MarcoStrassia/UltimateVroom/MotorController-Rebuild/docs/boosted-v1-esc-reference.png

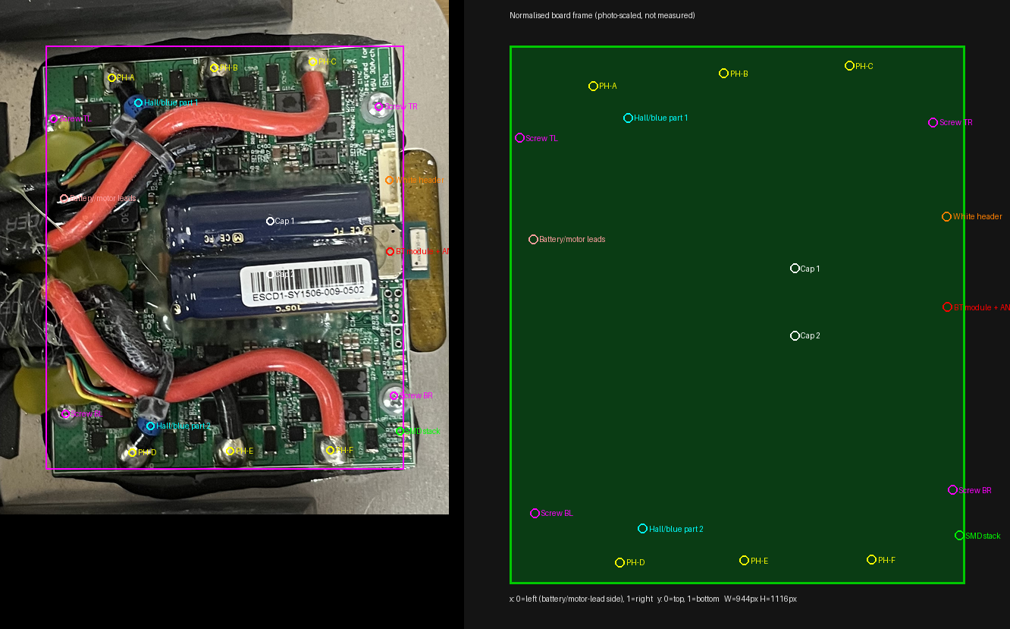
MotorController-Rebuild/docs/boosted-v1-esc-reference.png
