MarcoStrassia/UltimateVroom/MotorController-Rebuild/docs/photos/esc-corner-leds.jpg

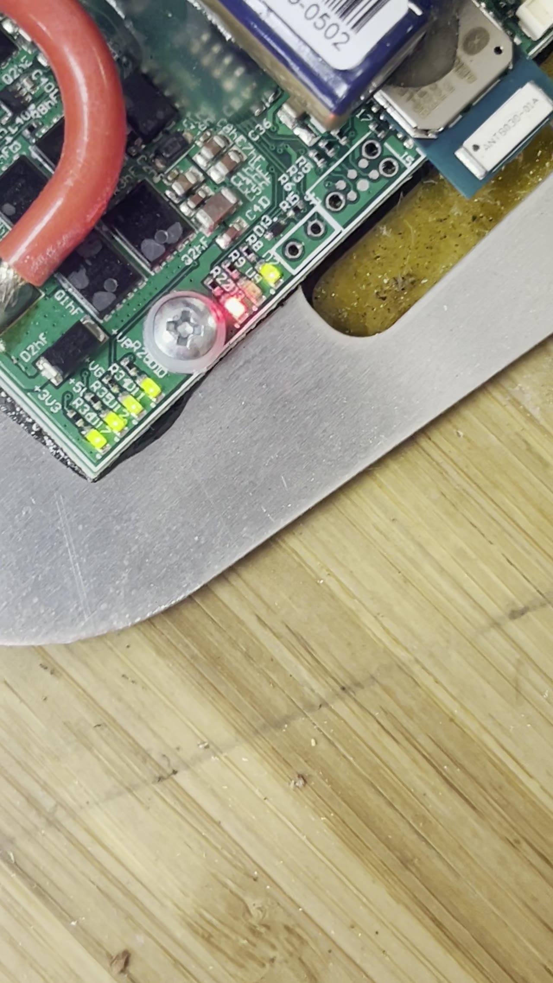
MotorController-Rebuild/docs/photos/esc-corner-leds.jpg
