MarcoStrassia/UltimateVroom/MotorController-Rebuild/docs/photos/esc-angled.jpg

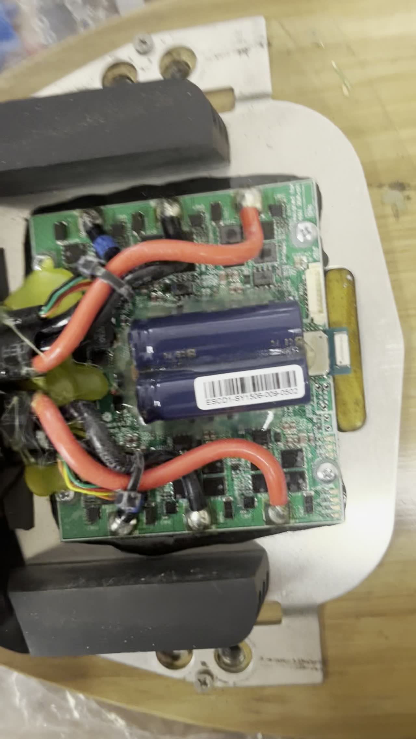
MotorController-Rebuild/docs/photos/esc-angled.jpg
