MarcoStrassia/UltimateVroom/MotorController-Rebuild/docs/photos/esc-top-crop.jpg

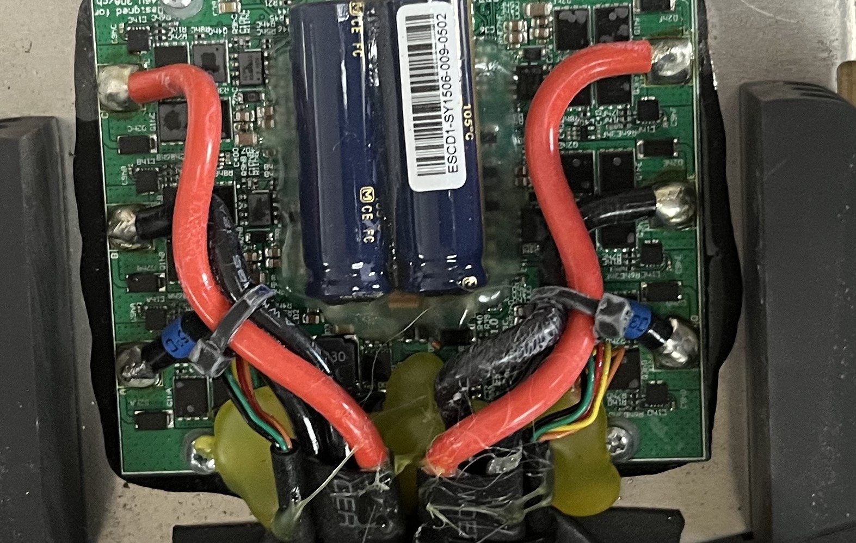
MotorController-Rebuild/docs/photos/esc-top-crop.jpg
