MarcoStrassia/UltimateVroom/MotorController-Rebuild/docs/photos/esc-top.jpg

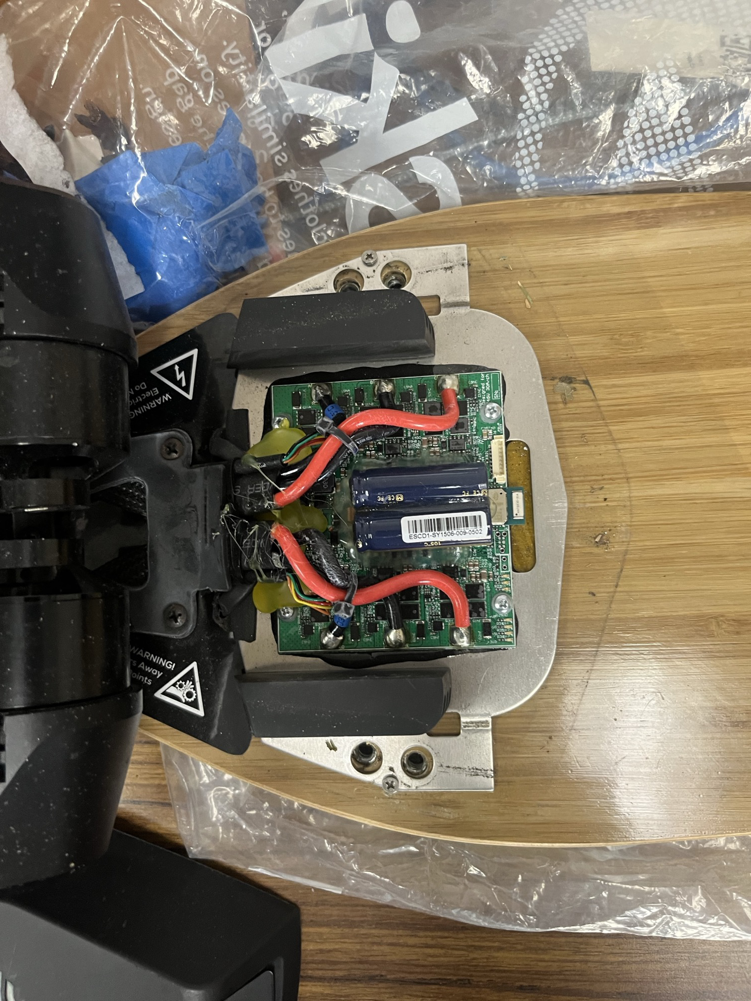
MotorController-Rebuild/docs/photos/esc-top.jpg
