MarcoStrassia/UltimateVroom/MotorController-Rebuild/review/current/previews/bottom.png

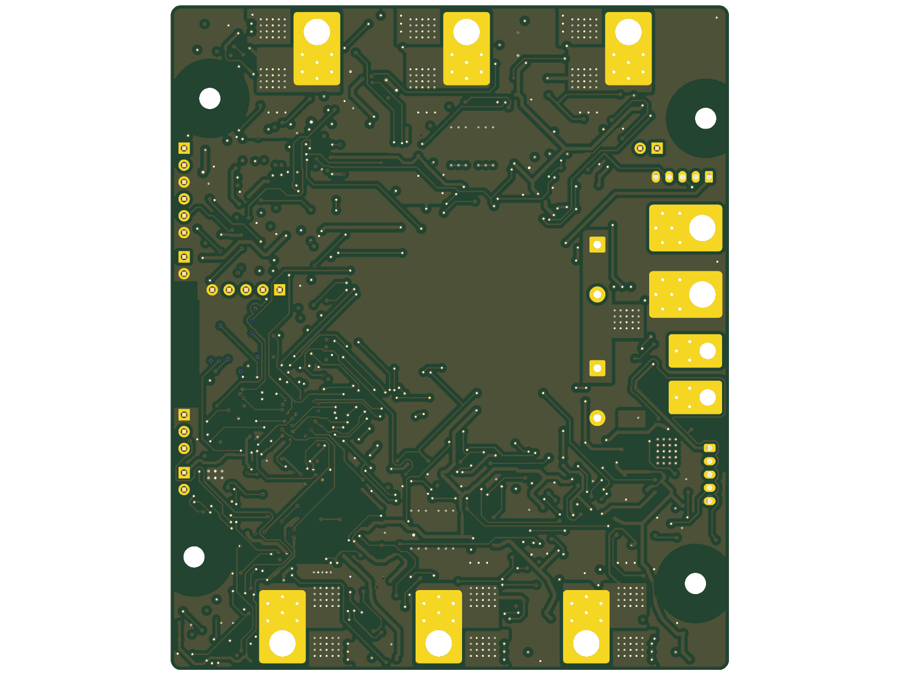
MotorController-Rebuild/review/current/previews/bottom.png
