MarcoStrassia/UltimateVroom/MotorController-Rebuild/review/current/previews/final-assembly.png

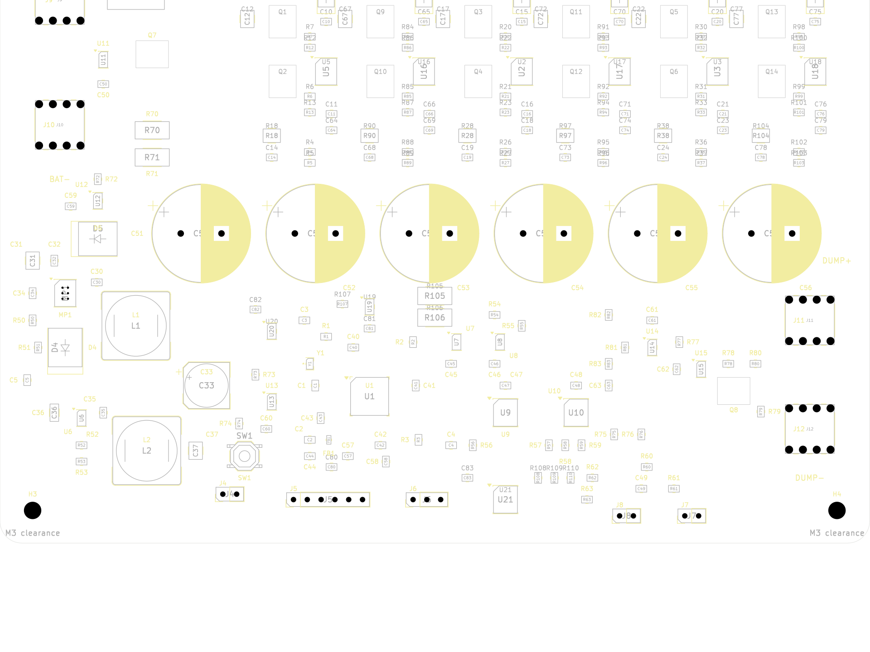
MotorController-Rebuild/review/current/previews/final-assembly.png
