MarcoStrassia/UltimateVroom/MotorController-Rebuild/review/current/previews/final-bottom.png

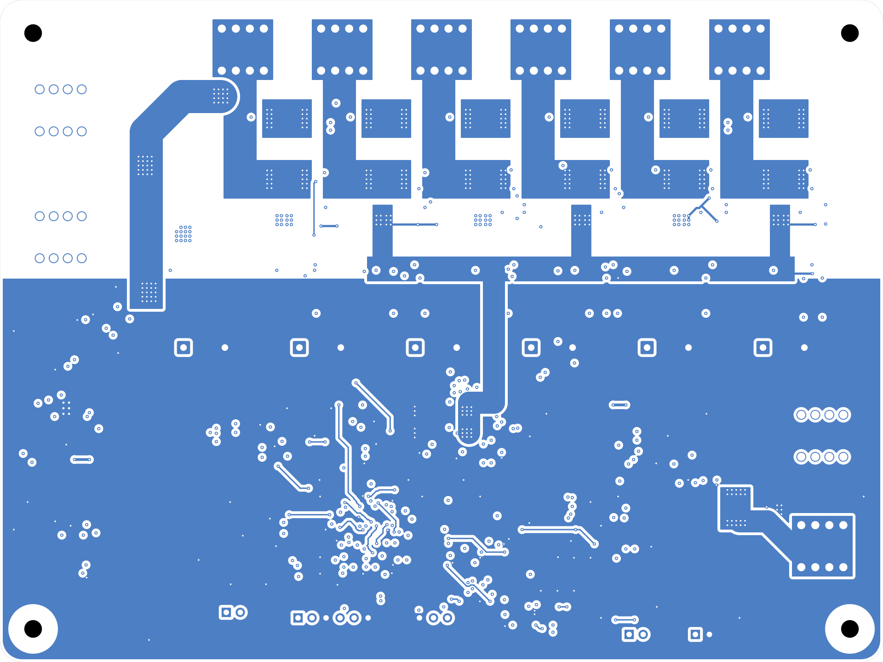
MotorController-Rebuild/review/current/previews/final-bottom.png
