MarcoStrassia/UltimateVroom/MotorController-Rebuild/review/current/previews/final-ground-in1.png

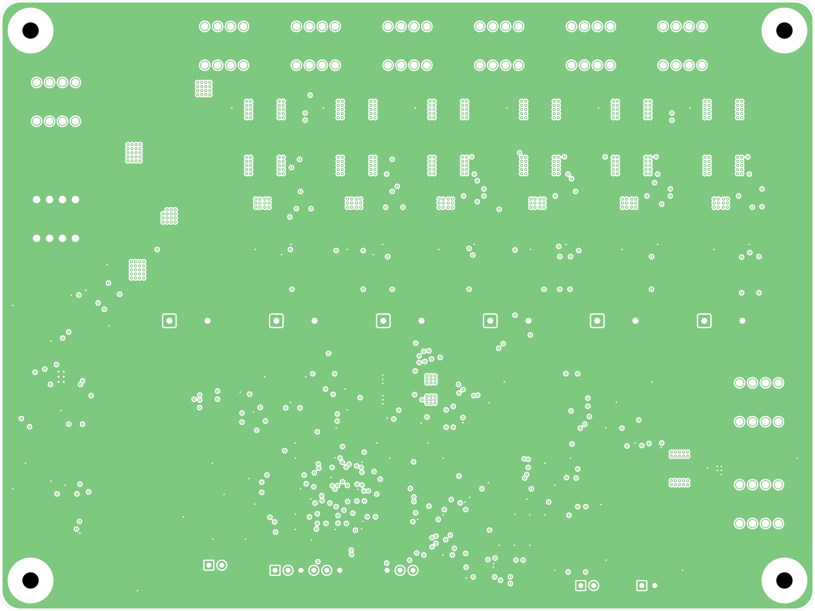
MotorController-Rebuild/review/current/previews/final-ground-in1.png
