MarcoStrassia/UltimateVroom/MotorController-Rebuild/review/current/previews/final-power-in2.png

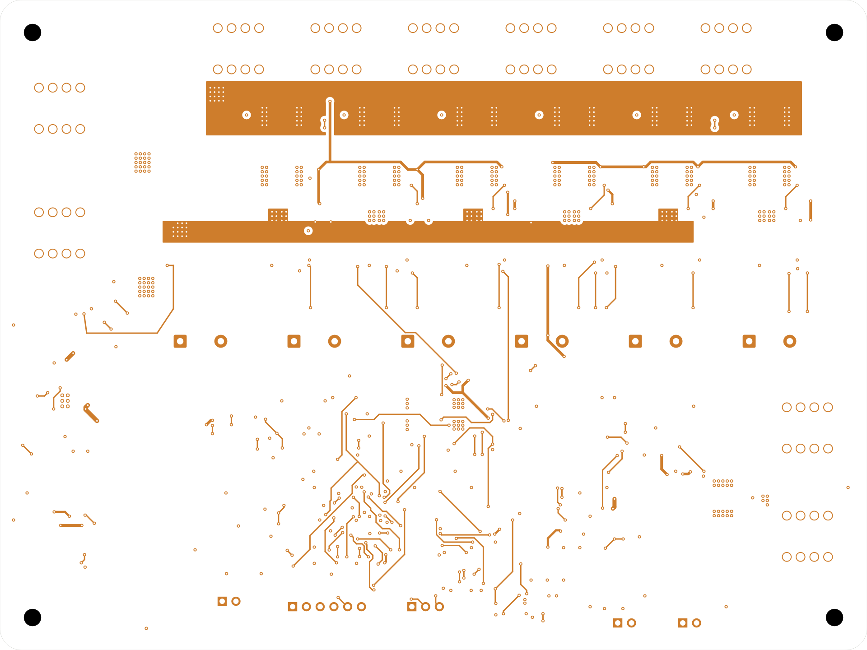
MotorController-Rebuild/review/current/previews/final-power-in2.png
