MarcoStrassia/UltimateVroom/MotorController-Rebuild/review/current/previews/final-top.png

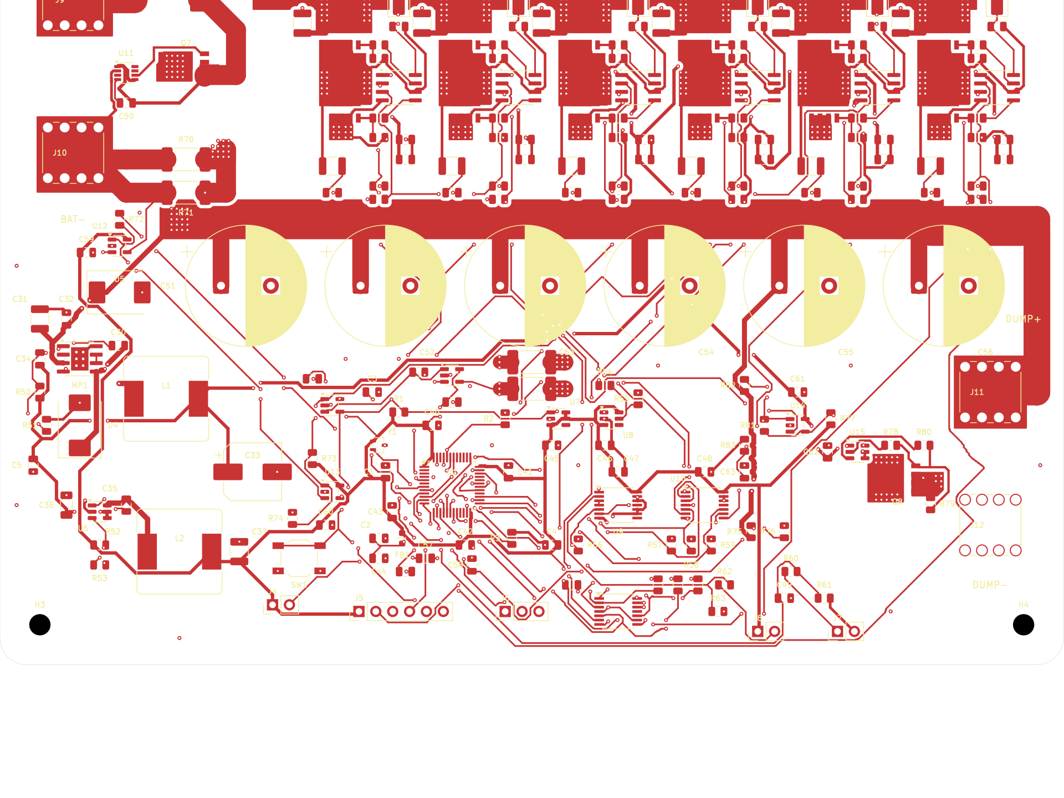
MotorController-Rebuild/review/current/previews/final-top.png
