MarcoStrassia/UltimateVroom/MotorController-Rebuild/review/current/previews/placement-top.png

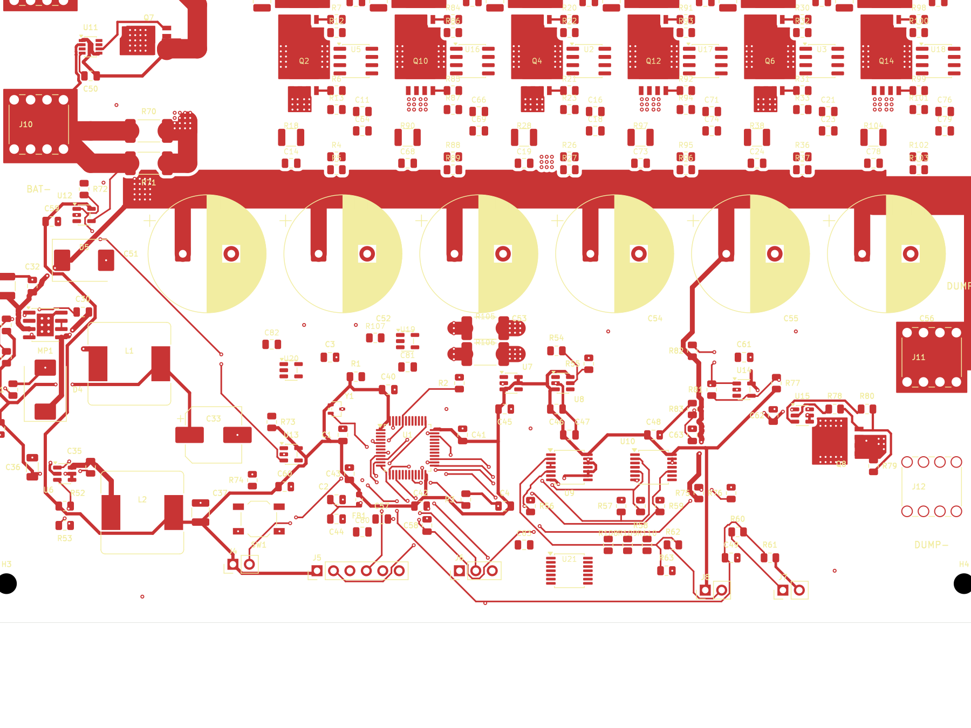
MotorController-Rebuild/review/current/previews/placement-top.png
