MarcoStrassia/UltimateVroom/MotorController-Rebuild/review/current/previews/top.png

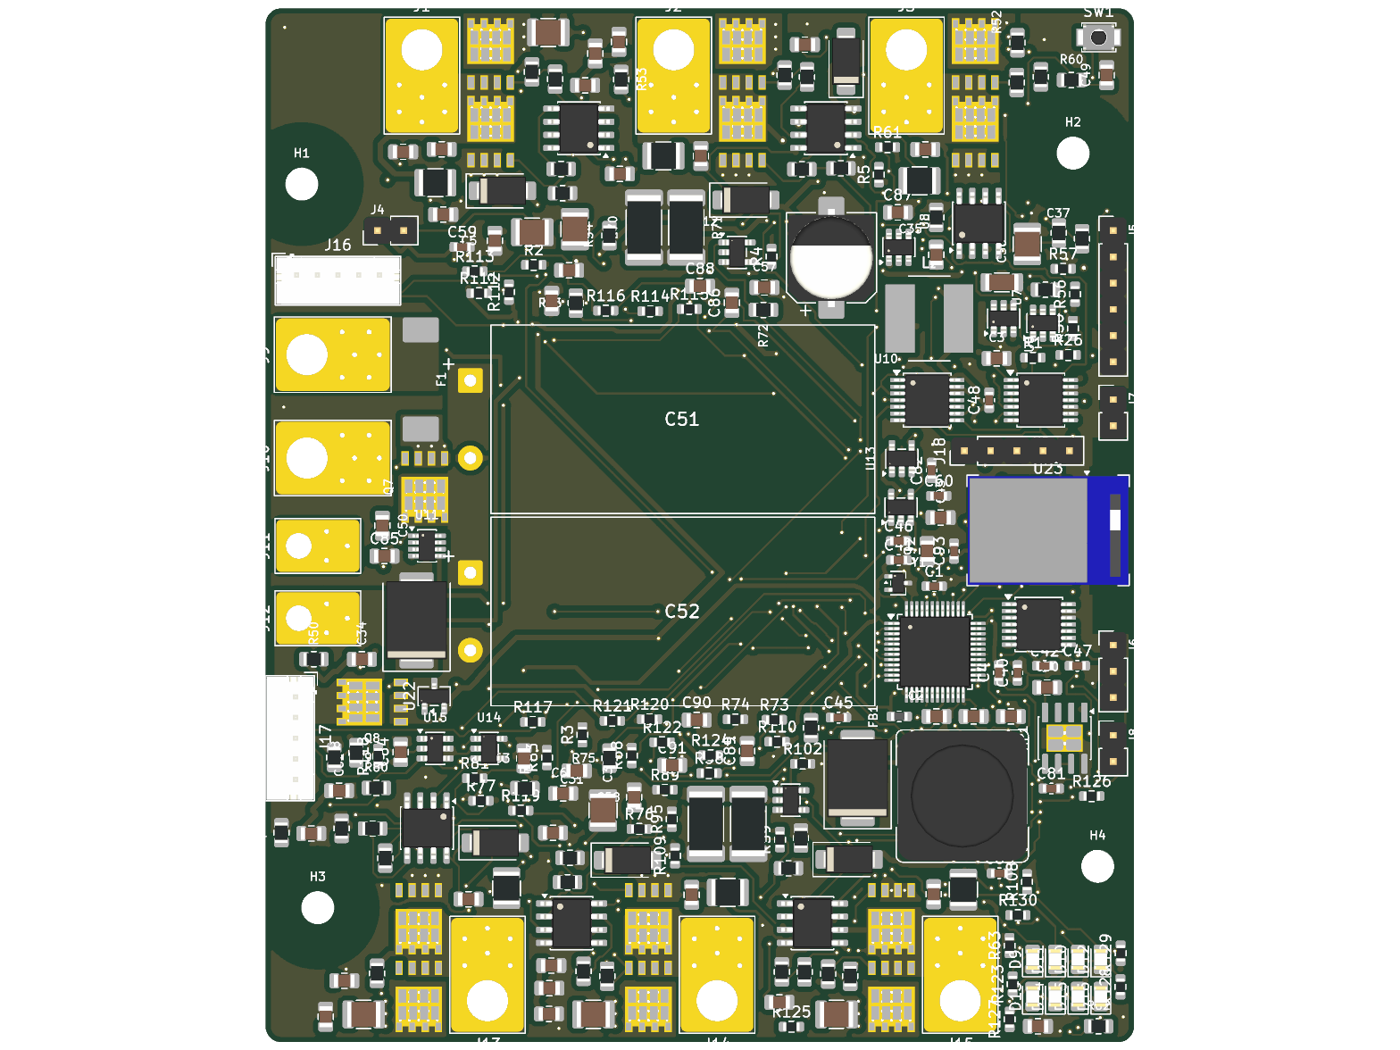
MotorController-Rebuild/review/current/previews/top.png
