MarcoStrassia/UltimateVroom/MotorController-Rebuild/review/current/previews/final-schematic.pdf

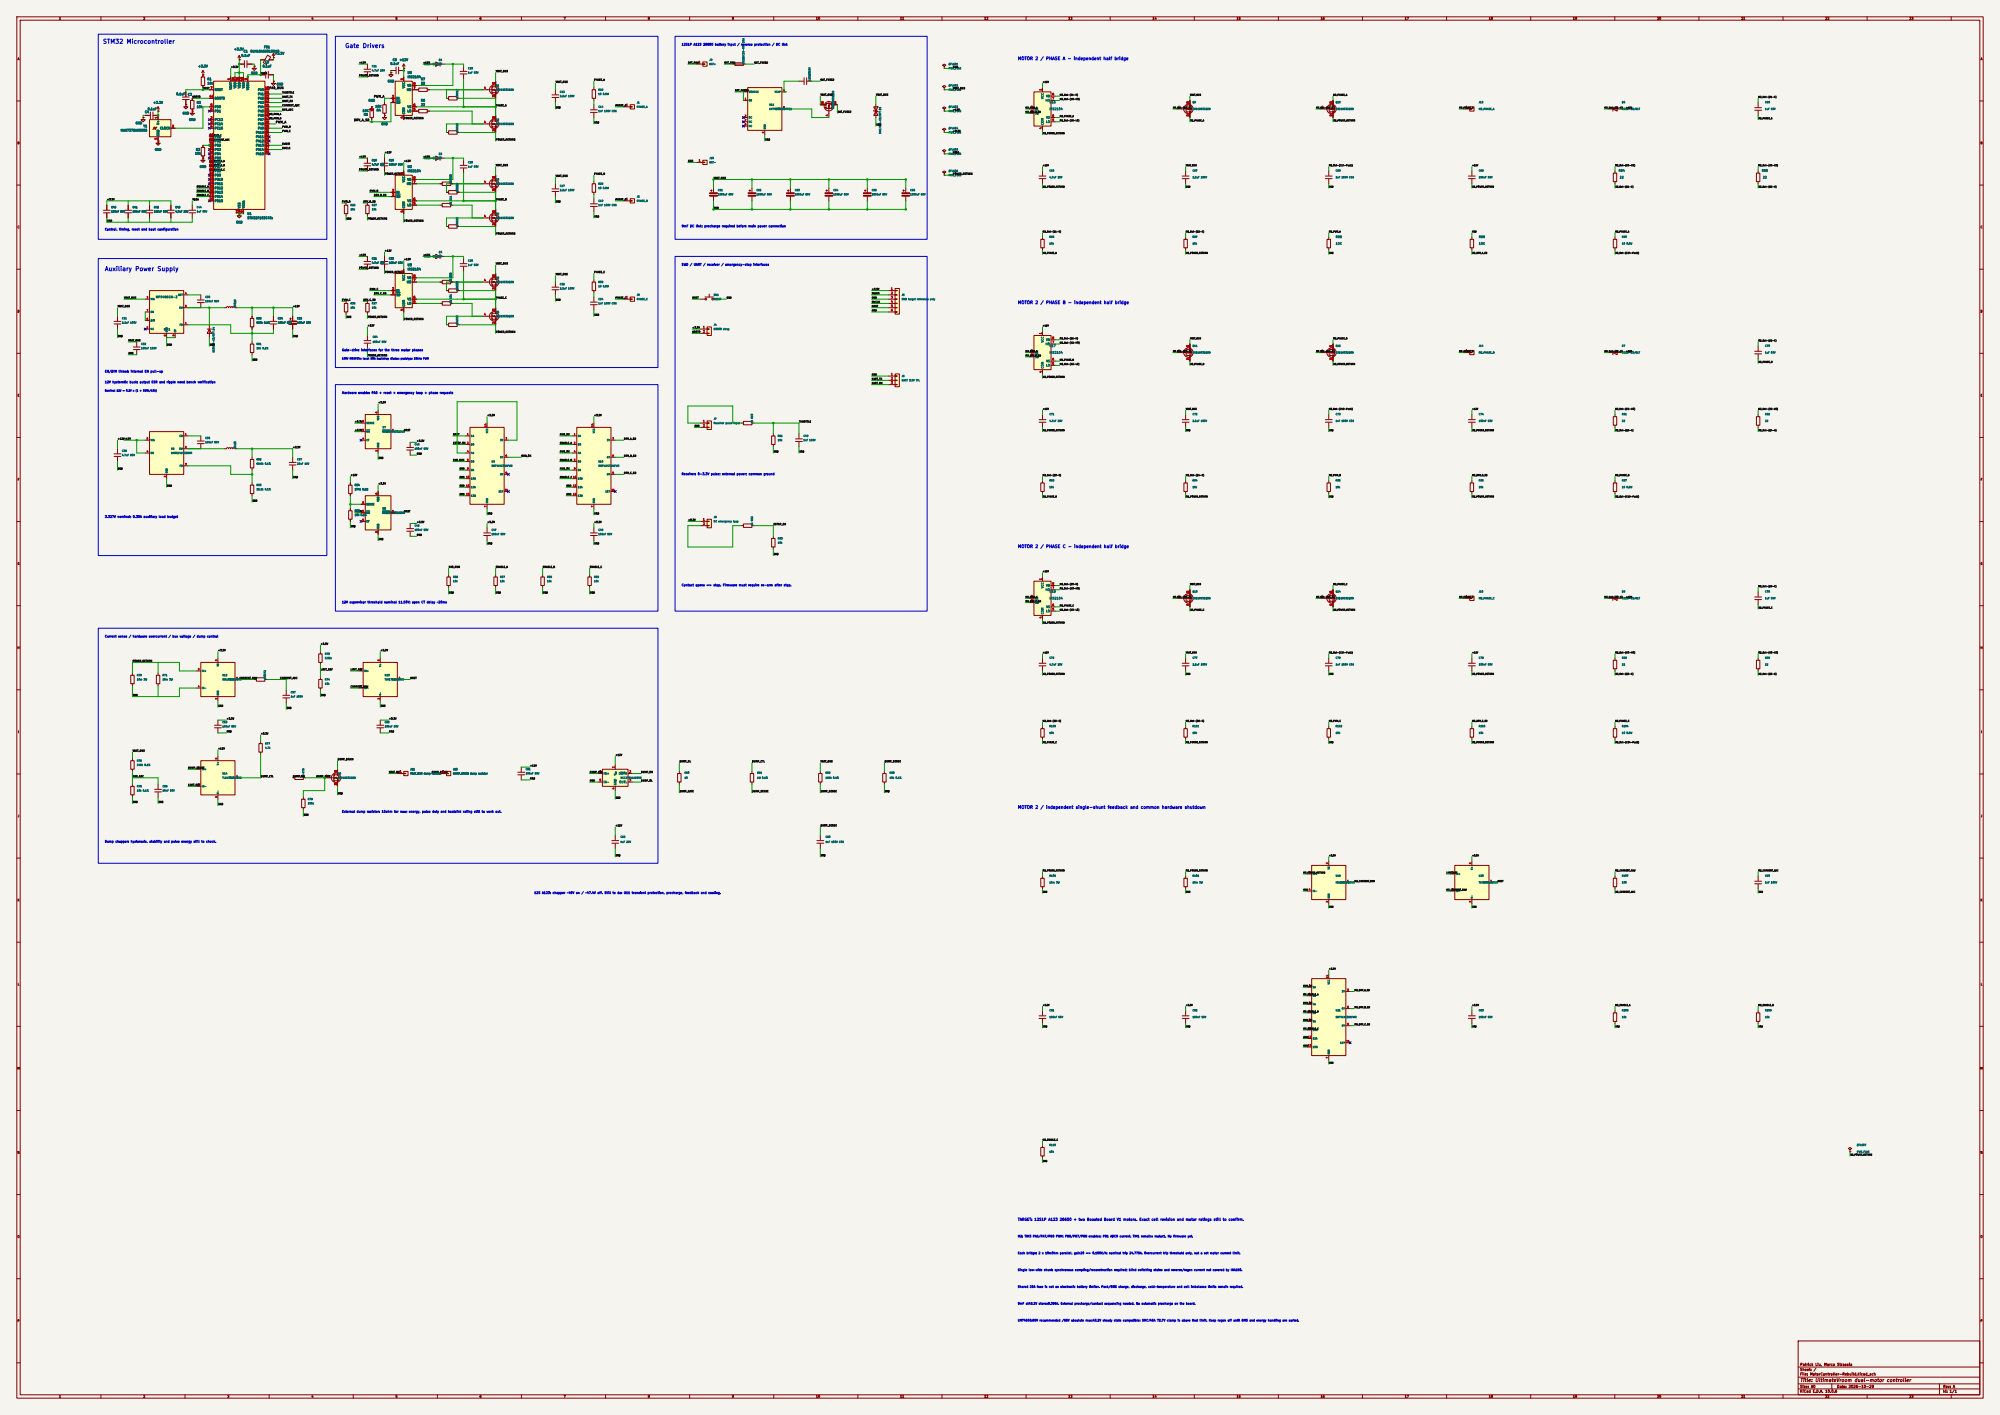
[picture p15: page 1]

12S1P A123 26650 battery input / reverse protection / DC link

MOTOR 2 / PHASE A - independent half bridge

SWD / UART / receiver / emergency-stop interfaces 9mF DC link; precharge required before main power connection Control, timing, reset and boot configuration

SWD target reference only

MOTOR 2 / PHASE B - independent half bridge
4.7uF 25V VCC

100V MOSFETs; local SMA bootstrap diodes; prototype 20kHz PWM

EN/DIM linked; internal EN pull-up

Hardware enable: PA0 + reset + emergency loop + phase requests

3.327V nominal; 0.30A auxiliary load budget

MOTOR 2 / PHASE C - independent half bridge

Contact opens => stop. Firmware must require re-arm after stop.

MOTOR 2 / independent single-shunt feedback and common hardware shutdown

Dump chopper: hysteresis, stability and pulse energy still to check.

12S A123: chopper ~48V on / ~47.4V off. Still to do: U11 transient protection, precharge, feedback and cooling.

TARGET: 12S1P A123 26650 + two Boosted Board V1 motors. Exact cell revision and motor ratings still to confirm.

M2: TIM3 PA6/PA7/PB0 PWM; PB6/PB7/PB8 enables; PB1 ADC9 current. TIM1 remains motor1. No firmware yet.

Each bridge: 2 x 10mOhm parallel, gain20 => 0.100V/A; nominal trip 24.775A. Overcurrent trip threshold only, not a set motor current limit.

Single low-side shunt: synchronous sampling/reconstruction required; blind switching states and reverse/regen current not covered by INA180. Shared 20A fuse is not an electronic battery limiter. Pack/BMS charge, discharge, cold-temperature and cell imbalance limits remain required.

9mF at43.2V stores8.398J. External precharge/contact sequencing needed. No automatic precharge on the board.

LM74500:60V recommended /65V absolute max;43.2V steady state compatible; SMCJ45A 72.7V clamp is above that limit. Keep regen off until BMS and energy handling are sorted.

Patrick Liu, Marco Strassia
Sheet: /
File: MotorController-Rebuild.kicad_sch
Title: UltimateVroom dual-motor controller

Size: A0 | Rev: A
KiCad E.D.A. 10.0.6 | Id: 1/1
