MarcoStrassia/UltimateVroom/MotorController-Rebuild/MotorController-Rebuild.kicad_pcb

## KiCad design MotorController-Rebuild/MotorController-Rebuild.kicad_pcb (2026-11-01)

Schematic: MotorController-Rebuild.kicad_sch, UltimateVroom dual-motor controller

Parts:
C1, C4: 0.1uF; C_0603_1608Metric; MPN C0603C104K5RACTU
C2, C3, C5: 0.1uF; C_0805_2012Metric; MPN C0805C104K5RACTU
C10, C15, C20, C44, C65, C70, C75, C84, C85: 1uF 50V; C_0805_2012Metric; MPN C0805C105K5RACTU
C11, C16, C21, C43, C66, C71, C76: 4.7uF 25V; C_0805_2012Metric; MPN C0805C475K3RACTU
C12, C17, C22, C31, C67, C72, C77: 2.2uF 100V; C_1210_3225Metric; MPN C1210C225K1RACTU
C14, C19, C24, C68, C73, C78: 1nF 100V C0G; C_0805_2012Metric; MPN C0805C102J1GACTU
C18, C23, C61, C64, C69, C74, C79: 100nF 50V; C_0805_2012Metric
C30, C34, C35: 100nF 50V; C_0805_2012Metric; MPN C0805C104K5RACTU
C32: 100nF 100V; C_0805_2012Metric; MPN C0805C104K1RACTU
C33: 100uF 25V; CP_Elec_8x10.5; MPN EEE-FK1E101P
C36: 4.7uF 50V; C_1206_3216Metric; MPN C1206C475K5RACTU
C37: 22uF 16V; C_1210_3225Metric; MPN C1210C226K4RACTU
C40, C41, C42, C45, C46, C47, C48, C59, C60, C81, C82, C83, C93: 100nF 50V; C_0603_1608Metric; MPN C0603C104K5RACTU
C49, C57, C80: 1nF 100V; C_0805_2012Metric
C50: 220nF 50V; C_0805_2012Metric; MPN C0805C224K5RACTU
C51, C52: 1500uF 80V; CP_Radial_D18.0mm_L35.5mm_P7.50mm_Horizontal; MPN EKYB800ELL152MMP1S
C58: 10nF 50V; C_0805_2012Metric
C62: 1uF 25V; C_0805_2012Metric
C63: 1nF 100V C0G; C_0805_2012Metric
C86, C87, C88, C89, C90, C91: 4.7nF 50V; C_0805_2012Metric; MPN C0805C472K5RACTU
C92: 10uF 10V; C_0805_2012Metric; MPN GRM21BR61A106KE19L
D1, D2, D3, D6, D7, D8: US1G-E3/61T; D_SMA; MPN US1G-E3/61T
D4: SS3H10-E3/57T; D_SMC; MPN SS3H10-E3/57T
D5: SMCJ45A-E3/57T; D_SMC; MPN SMCJ45A-E3/57T
D9: 3V3 green; LED_0805_2012Metric; MPN LTST-C171GKT
D10: 5V green; LED_0805_2012Metric; MPN LTST-C171GKT
D11: VG 12V green; LED_0805_2012Metric; MPN LTST-C171GKT
D12: RUN green; LED_0805_2012Metric; MPN LTST-C171GKT
D13: FAULT red; LED_0805_2012Metric; MPN LTST-C171KRKT
D14: BLE green; LED_0805_2012Metric; MPN LTST-C171GKT
D15: M1 ARM green; LED_0805_2012Metric; MPN LTST-C171GKT
D16: M2 ARM green; LED_0805_2012Metric; MPN LTST-C171GKT
F1: 1025HC20-RTR 20A; Fuse_1025HC; MPN 1025HC20-RTR
FB1: BLM18AG601SN1D; L_0603_1608Metric
J1: PHASE_A; SolderPad_10AWG_7x11mm_D4.0mm
J2: PHASE_B; SolderPad_10AWG_7x11mm_D4.0mm
J3: PHASE_C; SolderPad_10AWG_7x11mm_D4.0mm
J4: BOOT0 strap; PinHeader_1x02_P2.54mm_Vertical
J5: SWD target reference only; PinHeader_1x06_P2.54mm_Vertical
J6: UART 3.3V TTL; PinHeader_1x03_P2.54mm_Vertical
J7: Receiver pulse input; PinHeader_1x02_P2.54mm_Vertical
J8: NC emergency loop; PinHeader_1x02_P2.54mm_Vertical
J9: BAT+; SolderPad_10AWG_7x11mm_D4.0mm
J10: BAT-; SolderPad_10AWG_7x11mm_D4.0mm
J11: VBAT_BUS dump resistor; SolderPad_14AWG_5x8mm_D2.5mm
J12: DUMP_DRAIN dump resistor; SolderPad_14AWG_5x8mm_D2.5mm
J13: M2_PHASE_A; SolderPad_10AWG_7x11mm_D4.0mm
J14: M2_PHASE_B; SolderPad_10AWG_7x11mm_D4.0mm
J15: M2_PHASE_C; SolderPad_10AWG_7x11mm_D4.0mm
J16: HALL_M1 JST-PH 5p; JST_PH_B5B-PH-K_1x05_P2.00mm_Vertical; MPN B5B-PH-K-S(LF)(SN)
J17: HALL_M2 JST-PH 5p; JST_PH_B5B-PH-K_1x05_P2.00mm_Vertical; MPN B5B-PH-K-S(LF)(SN)
J18: BLE SWD; PinHeader_1x05_P2.54mm_Vertical; MPN PH1-05-UA (2.54 mm header)
L1: 100uH; L_Bourns_SRR1260; MPN SRR1260-101M
L2: 22uH; L_Bourns_SRN8040TA; MPN SRN8040TA-220M
MP1: MP9486GN-Z; MP9486_SOIC8_EP_0p4mm_thermal; Manufactuer PN MP9486GN-Z
Q1, Q2, Q3, Q4, Q5, Q6, Q7, Q8, Q9, Q10, Q11, Q12, Q13, Q14: CSD19532Q5B
R1, R2, R3: 10k; R_0603_1608Metric; Manufactuer PN CRT0603-BY-1002ELF
R4, R5, R88, R89: 10K; R_0603_1608Metric
R6, R7, R20, R21, R30, R31, R84, R85, R91, R92, R98, R99: 22; R_0805_2012Metric
R12, R13, R22, R23, R27, R32, R33, R37, R86, R87, R93, R94, R96, R100, R101, R103: 10k; R_0805_2012Metric
R18, R28, R38, R90, R97, R104: 10 0.5W; R_1210_3225Metric; MPN CRCW121010R0FKEA
R26, R36, R56, R57, R58, R59, R61, R63, R74, R95, R102, R108, R109, R110: 10k; R_0603_1608Metric
R50: 590k 0.1%; R_0805_2012Metric; MPN TNPW0805590KBEEA
R51, R55: 10k 0.1%; R_0805_2012Metric; MPN TNPW080510K0BEEA
R52: 69.8k 0.1%; R_0805_2012Metric; MPN TNPW080569K8BEEA
R53: 22.1k 0.1%; R_0805_2012Metric; MPN TNPW080522K1BEEA
R54: 274k 0.1%; R_0805_2012Metric; MPN TNPW0805274KBEEA
R60, R62: 1k; R_0805_2012Metric
R70, R71, R105, R106: 10m 3W; WSLP2512_10m; MPN WSLP2512R0100FEA
R72, R107: 100; R_0805_2012Metric
R73: 3.32k; R_0603_1608Metric
R75: 249k 0.1%; R_0805_2012Metric
R76, R83: 10k 0.1%; R_0603_1608Metric
R77: 4.7k; R_0603_1608Metric
R78, R80: 10; R_0805_2012Metric
R79: 100k; R_0805_2012Metric
R81: 1M 0.1%; R_0603_1608Metric
R82: 182k 0.1%; R_0805_2012Metric
R111, R112, R113, R117, R118, R119, R124: 2.2k; R_0603_1608Metric; MPN RC0603FR-072K2L
R114, R115, R116, R120, R121, R122: 10k; R_0603_1608Metric; MPN RC0603FR-0710KL
R123, R126, R127, R130: 1k; R_0603_1608Metric; MPN RC0603FR-071KL
R125: 4.7k; R_0603_1608Metric; MPN RC0603FR-074K7L
R128, R129: 1.5k; R_0603_1608Metric; MPN RC0603FR-071K5L
SW1: RESET; SW_SPST_B3U-1000P; MPN B3U-1000P
U1: STM32F103C4Tx; LQFP-48_7x7mm_P0.5mm; MPN STM32F103C4T6
U2, U3, U5, U16, U17, U18: IRS2104; SOIC-8_3.9x4.9mm_P1.27mm; MPN IRS2104STRPBF
U6: LMR51410XDBVR; SOT-23-6; MPN LMR51410XDBVR
U7: TPS3808G33DBVR; SOT-23-6; MPN TPS3808G33DBVR
U8: TPS3808G01DBVR; SOT-23-6; MPN TPS3808G01DBVR
U9, U10, U21: SN74LVC08APWR; TSSOP-14_4.4x5mm_P0.65mm; MPN SN74LVC08APWR
U11: LM74500QDDFRQ1; TI_DDF0008A; MPN LM74500QDDFRQ1
U12, U19: INA180A1IDBVR; SOT-23-5; MPN INA180A1IDBVR
U13, U14, U20: TLV1701AIDBVR; SOT-23-5; MPN TLV1701AIDBVR
U15: UCC27511ADBVR; SOT-23-6
U22: TLV76050DBZR; SOT-23-3; MPN TLV76050DBZR
U23: MDBT50Q-1MV2; Raytac_MDBT50Q; MPN MDBT50Q-1MV2
Y1: MAX7375AXR805; SOT-323_SC-70; Manufactuer PN MAX7375AXR805+T

Connections:
+3.3V: C1.1, C4.2, C37.1, C40.1, C41.1, C42.1, C43.1, C45.1, C46.1, C47.1, C48.1, C59.1, C60.1, C81.1, C82.1, C83.1, C92.1, C93.1, FB1.2, J4.1, J5.1, J8.1, J18.1, L2.2, R1.1, R52.1, R73.1, R77.1, R111.1, R112.1, R113.1, R117.1, R118.1, R119.1, R123.1, R127.1, R128.1, R129.1, U1.1 (VBAT), U1.24 (VDD), U1.36 (VDD), U1.48 (VDD), U7.3 (~MR), U7.5 (SENSE), U7.6 (VDD), U8.3 (~MR), U8.6 (VDD), U9.14 (VCC), U10.14 (VCC), U12.5 (VS), U13.5 (V+), U19.5 (VS), U20.5 (V+), U21.14 (VCC), U23.28 (VDD), U23.30 (VDDH), Y1.1 (V+)
+5V: C85.1, J16.1, J17.1, R124.1, U22.1 (OUT)
+12V: C5.2, C11.1, C16.1, C18.1, C21.1, C23.1, C33.1, C34.1, C36.1, C61.1, C62.1, C64.1, C66.1, C69.1, C71.1, C74.1, C76.1, C79.1, C84.1, D1.2 (A), D2.2 (A), D3.2 (A), D6.2 (A), D7.2 (A), D8.2 (A), L1.2, R50.1, R54.1, R125.1, U2.1 (VCC), U3.1 (VCC), U5.1 (VCC), U6.4 (EN), U6.5 (VIN), U14.5 (V+), U15.1 (V_{DD}), U16.1 (VCC), U17.1 (VCC), U18.1 (VCC), U22.2 (IN)
/BAT_FUSED: C50.2, F1.2, Q7.1 (S), Q7.2 (S), Q7.3 (S), U11.1 (EN), U11.5 (SOURCE)
/BAT_RAW: F1.1, J9.1
/BLE_NRST: J18.4, U1.41 (PB5), U23.40 (P0.18)
/BLE_STATUS: D14.1 (K), U1.3 (PC14), U23.36 (P0.14)
/BLE_UART_RX: U1.43 (PB7), U23.22 (P0.06)
/BLE_UART_TX: U1.42 (PB6), U23.24 (P0.08)
/BOOT0: J4.2, R2.1, U1.44 (BOOT0)
/BUS_ADC: C58.1, R75.2, R76.1, U1.15 (PA5)
/CURRENT_ADC: C57.1, R72.2, U1.14 (PA4)
/CURRENT_RAW: R72.1, U12.1 (OUT), U13.3 (IN-)
/DRV_A_SD: R5.2, U5.3 (~SD), U10.3 (3Y)
/DRV_B_SD: R27.1, U2.3 (~SD), U10.6 (6Y)
/DRV_C_SD: R37.1, U3.3 (~SD), U10.8 (8Y)
/DUMP_CTL: R77.2, R81.1, U14.4 (OUT), U15.6 (IN+)
/DUMP_DRAIN: J12.1, Q8.5 (D), Q8.6 (D), Q8.7 (D), Q8.8 (D)
/DUMP_GATE: Q8.4 (G), R78.2, R79.1, R80.2
/DUMP_OH: R78.1, U15.2 (OUTH)
/DUMP_OL: R80.1, U15.3 (OUTL)
/DUMP_SENSE: C63.1, R81.2, R82.2, R83.1, U14.1 (IN+)
/ENABLE_A: R57.1, U1.25 (PB12), U10.2 (2B)
/ENABLE_B: R58.1, U1.26 (PB13), U10.5 (5B)
/ENABLE_C: R59.1, U1.27 (PB14), U10.10 (10B)
/ESTOP_OK: R62.2, R63.1, U9.2 (2B)
/LED_D9_A: D9.2 (A), R123.2
/LED_D10_A: D10.2 (A), R124.2
/LED_D11_A: D11.2 (A), R125.2
/LED_D12_A: D12.2 (A), R126.2
/LED_D13_A: D13.2 (A), R127.2
/LED_FAULT: D13.1 (K), U1.2 (PC13)
/LED_M1_ARMED: D15.1 (K), U1.4 (PC15)
/LED_M2_ARMED: R3.1, R130.1, U1.20 (PB2)
/LED_RUN: R126.1, U1.28 (PB15)
/LIMIT_REF: R73.2, R74.1, U13.1 (IN+), U14.3 (IN-), U20.1 (IN+)
/M1_HALL_A: J16.2, R111.2, R114.1
/M1_HALL_A_MCU: C86.1, R114.2, U1.38 (PA15)
/M1_HALL_B: J16.3, R112.2, R115.1
/M1_HALL_B_MCU: C87.1, R115.2, U1.39 (PB3)
/M1_HALL_C: J16.4, R113.2, R116.1
/M1_HALL_C_MCU: C88.1, R116.2, U1.21 (PB10)
/M2_CURRENT_ADC: C80.1, R107.2, U1.19 (PB1)
/M2_CURRENT_RAW: R107.1, U19.1 (OUT), U20.3 (IN-)
/M2_DRV_A_SD: R89.2, U16.3 (~SD), U21.3 (3Y)
/M2_DRV_B_SD: R96.1, U17.3 (~SD), U21.6 (6Y)
/M2_DRV_C_SD: R103.1, U18.3 (~SD), U21.8 (8Y)
/M2_ENABLE_A: R108.1, U1.32 (PA11), U21.2 (2B)
/M2_ENABLE_B: R109.1, U1.33 (PA12), U21.5 (5B)
/M2_ENABLE_C: R110.1, U1.45 (PB8), U21.10 (10B)
/M2_HALL_A: J17.2, R117.2, R120.1
/M2_HALL_A_MCU: C89.1, R120.2, U1.40 (PB4)
/M2_HALL_B: J17.3, R118.2, R121.1
/M2_HALL_B_MCU: C90.1, R121.2, U1.46 (PB9)
/M2_HALL_C: J17.4, R119.2, R122.1
/M2_HALL_C_MCU: C91.1, R122.2, U1.22 (PB11)
/M2_PHASE_A: C65.2, J13.1, Q9.1 (S), Q9.2 (S), Q9.3 (S), Q10.5 (D), Q10.6 (D), Q10.7 (D), Q10.8 (D), R86.2, R90.1, U16.6 (VS)
/M2_PHASE_B: C70.2, J14.1, Q11.1 (S), Q11.2 (S), Q11.3 (S), Q12.5 (D), Q12.6 (D), Q12.7 (D), Q12.8 (D), R93.2, R97.1, U17.6 (VS)
/M2_PHASE_C: C75.2, J15.1, Q13.1 (S), Q13.2 (S), Q13.3 (S), Q14.5 (D), Q14.6 (D), Q14.7 (D), Q14.8 (D), R100.2, R104.1, U18.6 (VS)
/M2_POWER_RETURN: C66.2, C69.2, C71.2, C74.2, C76.2, C79.2, Q10.1 (S), Q10.2 (S), Q10.3 (S), Q12.1 (S), Q12.2 (S), Q12.3 (S), Q14.1 (S), Q14.2 (S), Q14.3 (S), R87.2, R94.2, R96.2, R101.2, R103.2, R105.1, R106.1, U16.4 (COM), U17.4 (COM), U18.4 (COM), U19.3 (IN+)
/M2_PWM_A: R88.1, U1.16 (PA6), U16.2 (IN)
/M2_PWM_B: R95.1, U1.17 (PA7), U17.2 (IN)
/M2_PWM_C: R102.1, U1.18 (PB0), U18.2 (IN)
/NRST: C3.1, J5.5, R1.2, SW1.1, U1.7 (NRST), U7.1 (~RESET), U8.1 (~RESET), U9.1 (1A), U13.4 (OUT), U20.4 (OUT)
/PA0_RUN: R56.1, U1.10 (PA0), U9.5 (5B)
/PHASE_A: C10.2, J1.1, Q1.1 (S), Q1.2 (S), Q1.3 (S), Q2.5 (D), Q2.6 (D), Q2.7 (D), Q2.8 (D), R12.2, R18.1, U5.6 (VS)
/PHASE_B: C15.2, J2.1, Q3.1 (S), Q3.2 (S), Q3.3 (S), Q4.5 (D), Q4.6 (D), Q4.7 (D), Q4.8 (D), R22.2, R28.1, U2.6 (VS)
/PHASE_C: C20.2, J3.1, Q5.1 (S), Q5.2 (S), Q5.3 (S), Q6.5 (D), Q6.6 (D), Q6.7 (D), Q6.8 (D), R32.2, R38.1, U3.6 (VS)
/POWER_RETURN: C11.2, C16.2, C18.2, C21.2, C23.2, C64.2, Q2.1 (S), Q2.2 (S), Q2.3 (S), Q4.1 (S), Q4.2 (S), Q4.3 (S), Q6.1 (S), Q6.2 (S), Q6.3 (S), R13.2, R23.2, R27.2, R33.2, R37.2, R70.1, R71.1, U2.4 (COM), U3.4 (COM), U5.4 (COM), U12.3 (IN+)
/PWM_A: R4.1, U1.29 (PA8), U5.2 (IN)
/PWM_B: R26.1, U1.30 (PA9), U2.2 (IN)
/PWM_C: R36.1, U1.31 (PA10), U3.2 (IN)
/RUN_OK: U9.6 (6Y), U10.1 (1A), U10.4 (4A), U10.9 (9A), U21.1 (1A), U21.4 (4A), U21.9 (9A)
/SWCLK: J5.4, U1.37 (PA14)
/SWDIO: J5.2, U1.34 (PA13)
/THROTTLE: C49.1, R60.2, R61.1, U1.11 (PA1)
/UART_RX: J6.3, U1.13 (PA3)
/UART_TX: J6.2, U1.12 (PA2)
/VBAT_BUS: C12.1, C17.1, C22.1, C31.1, C32.1, C51.1, C52.1, C67.1, C72.1, C77.1, D5.1 (A1), J11.1, MP1.3 (VIN), Q1.5 (D), Q1.6 (D), Q1.7 (D), Q1.8 (D), Q3.5 (D), Q3.6 (D), Q3.7 (D), Q3.8 (D), Q5.5 (D), Q5.6 (D), Q5.7 (D), Q5.8 (D), Q7.5 (D), Q7.6 (D), Q7.7 (D), Q7.8 (D), Q9.5 (D), Q9.6 (D), Q9.7 (D), Q9.8 (D), Q11.5 (D), Q11.6 (D), Q11.7 (D), Q11.8 (D), Q13.5 (D), Q13.6 (D), Q13.7 (D), Q13.8 (D), R75.1, R82.1
/VDDA: C2.1, C44.1, FB1.1, U1.9 (VDDA)
GND: C1.2, C2.2, C3.2, C4.1, C5.1, C12.2, C14.2, C17.2, C19.2, C22.2, C24.2, C31.2, C32.2, C33.2, C36.2, C37.2, C40.2, C41.2, C42.2, C43.2, C44.2, C45.2, C46.2, C47.2, C48.2, C49.2, C51.2, C52.2, C57.2, C58.2, C59.2, C60.2, C61.2, C62.2, C63.2, C67.2, C68.2, C72.2, C73.2, C77.2, C78.2, C80.2, C81.2, C82.2, C83.2, C84.2, C85.2, C86.2, C87.2, C88.2, C89.2, C90.2, C91.2, C92.2, C93.2, D4.2 (A), D5.2 (A2), D9.1 (K), D10.1 (K), D11.1 (K), D12.1 (K), D16.1 (K), J5.3, J5.6, J6.1, J7.2, J10.1, J16.5, J17.5, J18.5, MP1.8 (GND), MP1.9 (EP), Q8.1 (S), Q8.2 (S), Q8.3 (S), R2.2, R3.2, R4.2, R5.1, R26.2, R36.2, R51.2, R53.2, R55.2, R56.2, R57.2, R58.2, R59.2, R61.2, R63.2, R70.2, R71.2, R74.2, R76.2, R79.2, R83.2, R88.2, R89.1, R95.2, R102.2, R105.2, R106.2, R108.2, R109.2, R110.2, SW1.2, U1.8 (VSSA), U1.23 (VSS), U1.35 (VSS), U1.47 (VSS), U6.2 (GND), U7.2 (GND), U8.2 (GND), U9.7 (GND), U9.9 (9A), U9.10 (10B), U9.12 (12A), U9.13 (13B), U10.7 (GND), U10.12 (12A), U10.13 (13B), U11.2 (GND), U12.2 (GND), U12.4 (IN-), U13.2 (V-), U14.2 (V-), U15.4 (GND), U15.5 (IN-), U19.2 (GND), U19.4 (IN-), U20.2 (V-), U21.7 (GND), U21.12 (12A), U21.13 (13B), U22.3 (GND), U23.1 (GND), U23.2 (GND), U23.15 (GND), U23.33 (GND), U23.55 (GND), Y1.3 (GND)
unnamed: C14.1, R18.2
unnamed: C19.1, R28.2
unnamed: C24.1, R38.2
unnamed: C68.1, R90.2
unnamed: C73.1, R97.2
unnamed: C78.1, R104.2
unnamed: C10.1, D1.1 (K), U5.8 (VB)
unnamed: C15.1, D2.1 (K), U2.8 (VB)
unnamed: C20.1, D3.1 (K), U3.8 (VB)
unnamed: C30.2, D4.1 (K), L1.1, MP1.5 (SW)
unnamed: C65.1, D6.1 (K), U16.8 (VB)
unnamed: C70.1, D7.1 (K), U17.8 (VB)
unnamed: C75.1, D8.1 (K), U18.8 (VB)
unnamed: D14.2 (A), R128.2
unnamed: D15.2 (A), R129.2
unnamed: D16.2 (A), R130.2
unnamed: J7.1, R60.1
unnamed: J8.2, R62.1
unnamed: J18.2, U23.51 (SWDIO)
unnamed: J18.3, U23.53 (SWDCLK)
unnamed: C30.1, MP1.4 (BST)
unnamed: MP1.6 (DIM), MP1.7 (EN)
unnamed: C34.2, MP1.1 (FB), R50.2, R51.1
unnamed: Q1.4 (G), R7.2, R12.1
unnamed: Q2.4 (G), R6.2, R13.1
unnamed: Q3.4 (G), R20.2, R22.1
unnamed: Q4.4 (G), R21.2, R23.1
unnamed: Q5.4 (G), R30.2, R32.1
unnamed: Q6.4 (G), R31.2, R33.1
unnamed: Q7.4 (G), U11.6 (GATE)
unnamed: Q9.4 (G), R84.2, R86.1
unnamed: Q10.4 (G), R85.2, R87.1
unnamed: Q11.4 (G), R91.2, R93.1
unnamed: Q12.4 (G), R92.2, R94.1
unnamed: Q13.4 (G), R98.2, R100.1
unnamed: Q14.4 (G), R99.2, R101.1
unnamed: U1.5 (PD0), Y1.2 (CLOCK)
unnamed: R20.1, U2.7 (HO)
unnamed: R21.1, U2.5 (LO)
unnamed: R30.1, U3.7 (HO)
unnamed: R31.1, U3.5 (LO)
unnamed: R7.1, U5.7 (HO)
unnamed: R6.1, U5.5 (LO)
unnamed: C35.1, U6.1 (CB)
unnamed: R52.2, R53.1, U6.3 (FB)
unnamed: C35.2, L2.1, U6.6 (SW)
unnamed: R54.2, R55.1, U8.5 (SENSE)
unnamed: U9.3 (3Y), U9.4 (4A)
unnamed: C50.1, U11.4 (VCAP)
unnamed: R84.1, U16.7 (HO)
unnamed: R85.1, U16.5 (LO)
unnamed: R91.1, U17.7 (HO)
unnamed: R92.1, U17.5 (LO)
unnamed: R98.1, U18.7 (HO)
unnamed: R99.1, U18.5 (LO)

Notes on the sheet:
Control, timing, reset and boot configuration
100V MOSFETs; local SMA bootstrap diodes; prototype 20kHz PWM
12V hysteretic buck: output ESR and ripple need bench verification
Nominal 12V = 0.2V x (1 + 590k/10k)
EN/DIM linked; internal EN pull-up
3.327V nominal; 0.30A auxiliary load budget
12V supervisor threshold nominal 11.50V; open CT delay ~20ms
Receiver: 0-3.3V pulse; external power; common ground
Contact opens => stop. Firmware must require re-arm after stop.
2 x 1500 uF / 80 V lying-flat cans (3 mF); ripple rating is the limit, see BOOSTED-V1-SCHEMATIC-CHANGES.md. Precharge still required.
External dump resistor: 10ohm for now; energy, pulse duty and heatsink rating still to work out.
Dump chopper: hysteresis, stability and pulse energy still to check.
12S A123: chopper ~48V on / ~47.4V off. Still to do: U11 transient protection, precharge, feedback and cooling.
TARGET: 12S1P A123 26650 + two Boosted Board V1 motors. Exact cell revision and motor ratings still to confirm.
M2: TIM3 PA6/PA7/PB0 PWM; PB6/PB7/PB8 enables; PB1 ADC9 current. TIM1 remains motor1. No firmware yet.
Each bridge: 2 x 10mOhm parallel, gain20 => 0.100V/A; nominal trip 24.775A. Overcurrent trip threshold only, not a set motor current limit.
Single low-side shunt: synchronous sampling/reconstruction required; blind switching states and reverse/regen current not covered by INA180.
Shared 20A fuse is not an electronic battery limiter. Pack/BMS charge, discharge, cold-temperature and cell imbalance limits remain required.
9mF at43.2V stores8.398J. External precharge/contact sequencing needed. No automatic precharge on the board.
LM74500:60V recommended /65V absolute max;43.2V steady state compatible; SMCJ45A 72.7V clamp is above that limit. Keep regen off until BMS and energy handling are sorted.
R3 = PB2/BOOT1
pull-down
Raytac MDBT50Q-1MV2 (Nordic nRF52840, chip antenna), KiCad RF_Module:MDBT50Q-1MV2 / Raytac_MDBT50Q.
Supply: +3.3V into VDD and VDDH tied (datasheet 8.3: Reg0 DC/DC and LDO off below 3.6 V); DCCH and VBUS unused.
Internal 32.768 kHz RC (datasheet 8: X2 optional). UART: MCU PB6 USART1_TX(remap) -> P0.08 RXD, MCU PB7 <- P0.06 TXD.
P0.14 = BLE_STATUS (connected, active low) -> D14 and MCU PC14. MCU PB5 (open drain) -> P0.18/nRESET; J18 = SWD.
PCB: antenna end on the right board edge; datasheet 2.3 no-ground keep-out (>= 3.8 mm, every layer) under the antenna.
Primary control path (BLE remote / phone). Wired receiver J7 stays as the fallback input.
D9 3V3 OK
+3.3 V rail present
rail-driven, no MCU pin
D11 12V GATE OK
+12 V gate rail present
D10 5V HALL
+5 V hall rail present
D12 HEARTBEAT
MCU PB15, active high
blinks while firmware runs
D13 FAULT / OVER-CURRENT
MCU PC13, active LOW (sink)
PC13-15 must not source
D14 BLE CONNECTED
BLE P0.14, active LOW;
also read on MCU PC14
D15 MOTOR 1 ARMED
MCU PC15, active LOW (sink)
firmware: M1 enabled
D16 MOTOR 2 ARMED
MCU PB2, active high
R3 10k keeps BOOT1 low
Currents ~0.8-1.3 mA (VF 2.0 V typ, LTST-C171 series). Sinks: PC13/PC15 <= 3 mA, nRF P0.14 standard drive.
U22 TLV76050: +12V -> +5V hall rail (30 V max in, 100 mA)
Motor 1 hall connector (JST PH 5-pin): 1 +5V, 2 A, 3 B, 4 C, 5 GND
Motor 2 hall connector (JST PH 5-pin): 1 +5V, 2 A, 3 B, 4 C, 5 GND
Network copied from VESC 4.12 design/hall_filters.sch (vedderb/bldc-hardware): 2.2k pull-up to 3.3V, 10k series, 4.7nF to GND (RC 47 us).
MCU: M1 A/B/C = PA15/PB3/PB10 (TIM2 full remap CH1-3), M2 A/B/C = PB4/PB9/PB11. Firmware: SWJ_CFG=010 (SWD only) frees PA15/PB3/PB4.
Dump comparator sense: 182k/10k (0.1 %) divider with C63; R81 1M hysteresis to DUMP_CTL. R80 = UCC27511 low-side output to Q8 gate.
STM32 MCU
12 V gate supply
3.3 V supply
Gate drivers - motor 1
Motor 1 power stage (three half-bridges)
Hardware enable and shutdown - motor 1 + RUN_OK
Battery input and protection
Bus capacitors
Connectors and headers
Bus voltage and dump control
Gate drivers - motor 2
Motor 2 power stage (three half-bridges)
Hardware enable - motor 2
Current sensing (motor 1 top, motor 2 bottom)
Bluetooth module
Status LEDs
Hall sensor inputs
PA0 + reset + emergency loop + phase requests gate the motor-1 IRS2104 SD pins; RUN_OK also gates motor 2.

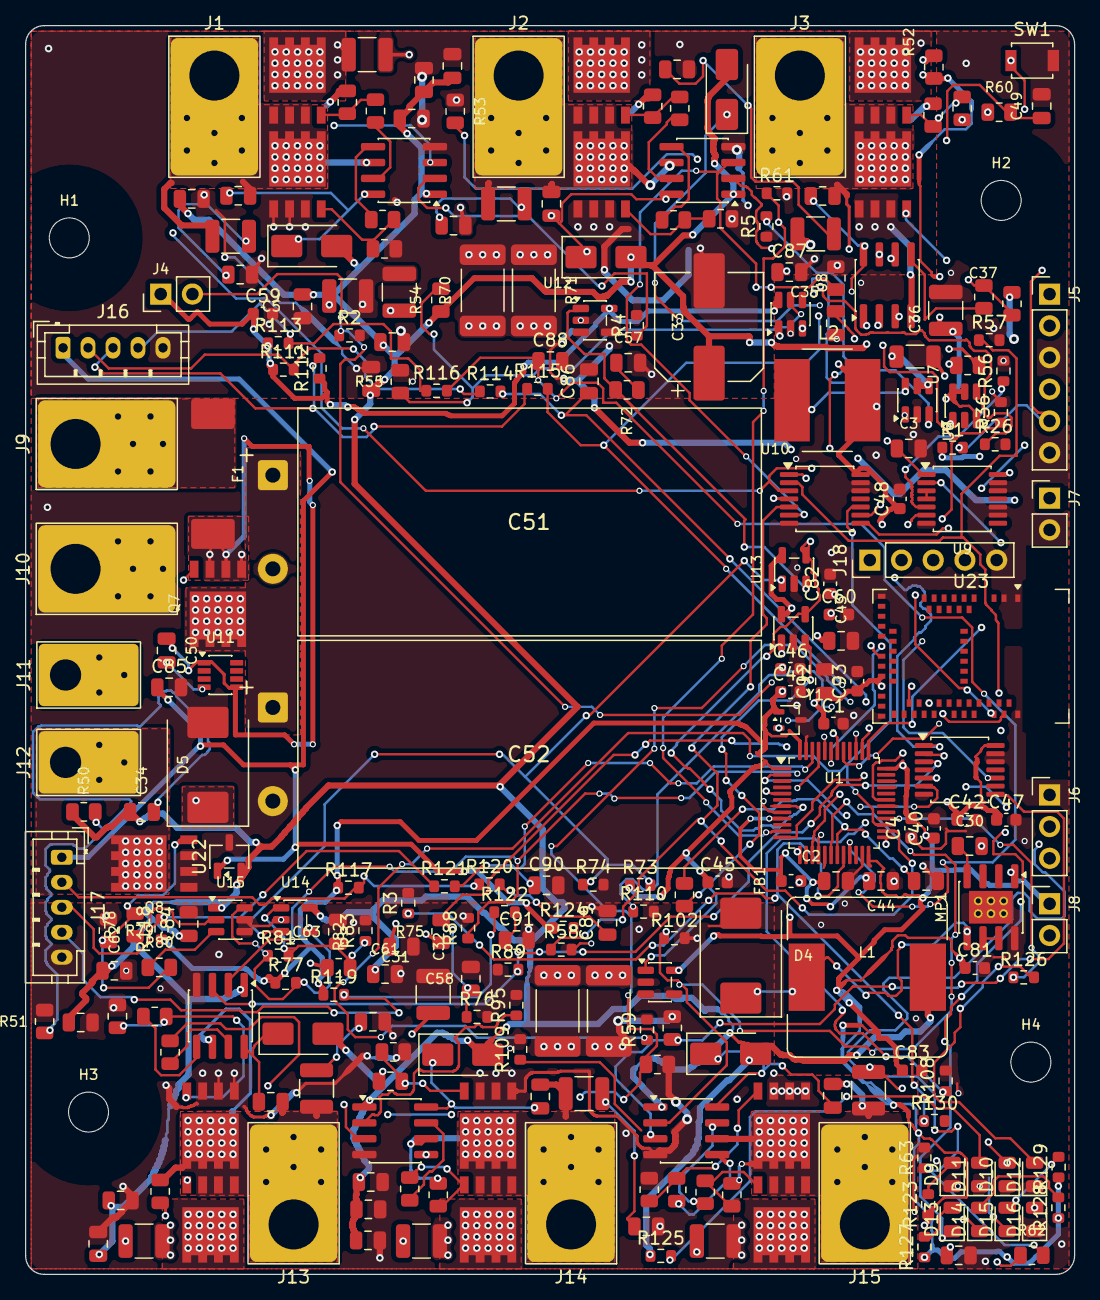
[picture p16: board MotorController-Rebuild.kicad_pcb from above]

Board: 4 copper layers, 84.0 x 100.0 mm, 257 parts (0 on the bottom side), 136 nets.

Other parts of the board:
H1, H2, H3, H4: M3 clearance; MountingHole_3.2mm_M3
