MarcoStrassia/UltimateVroom/(commit log)

2026-10-18 Initial commit for SkateboardMotorController
    [SkateboardMotorController.kicad_pcb, SkateboardMotorController.kicad_sch]
2026-10-18 Added STM32
    [SkateboardMotorController.kicad_sch]
2026-10-18 finished most of STM32 and started on Gate drivers
    [SkateboardMotorController.kicad_sch]
2026-10-19 progress on gate drivers and found 60V-12V converter
    [SkateboardMotorController.kicad_sch]
2026-10-22 finished 12V rail
    [SkateboardMotorController.kicad_sch]
2026-10-27 added 3.3V rail
    [SkateboardMotorController.kicad_sch]
2026-10-30 Add four-layer dual-motor controller board
    [MotorController-Rebuild.kicad_pcb, MotorController-Rebuild.kicad_sch]
2026-10-30 Add Boosted V1 ESC reference measurements, photos and design notes
2026-10-30 Clean up repo for review
    [SkateboardMotorController.kicad_pcb, SkateboardMotorController.kicad_sch]
2026-11-01 Move to the 84 x 100 drop-in layout
    The board now matches the original Boosted V1 ESC footprint: phase pads along the top and bottom edges, battery and dump pads on the left, mounting holes at the original screw positions, two bulk caps lying flat. Routing is in progress (76 connections still open, DRC 0 errors, schematic parity clean).
    [MotorController-Rebuild.kicad_pcb, MotorController-Rebuild.kicad_sch]
2026-11-01 Routing pass on the drop-in board
    Ground stitched, signals moved off the phase pours onto In1.Cu, 14 nets joined.
    Open connections 76 -> 35, DRC 0 errors, schematic parity clean. All six phases
    carry 30 A across F.Cu + B.Cu. Still open: 15 signal nets boxed in at U1/U21,
    13 GND pads, the return pours under the low-side FETs, and the bus pour on B.Cu.
    [MotorController-Rebuild.kicad_pcb]
